RandomAerospace/COMMS-BOARD/Board screenshots/COMMS_BOARD_top.png

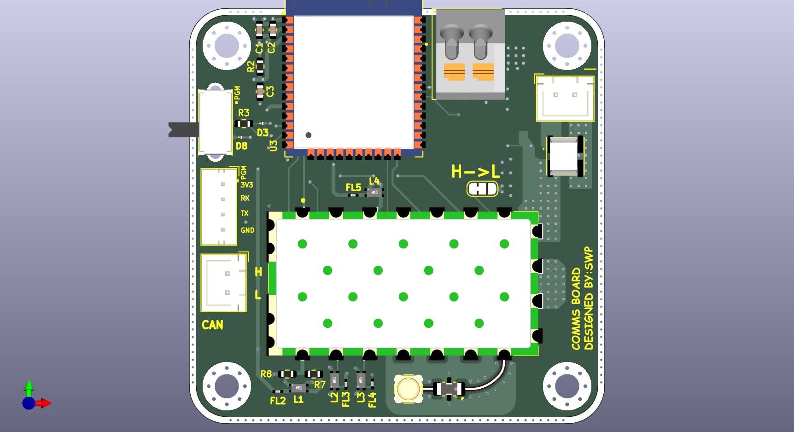
Board screenshots/COMMS_BOARD_top.png
