RandomAerospace/COMMS-BOARD/Board screenshots/COMMS_BOARD_REV1_BOTTOM.png

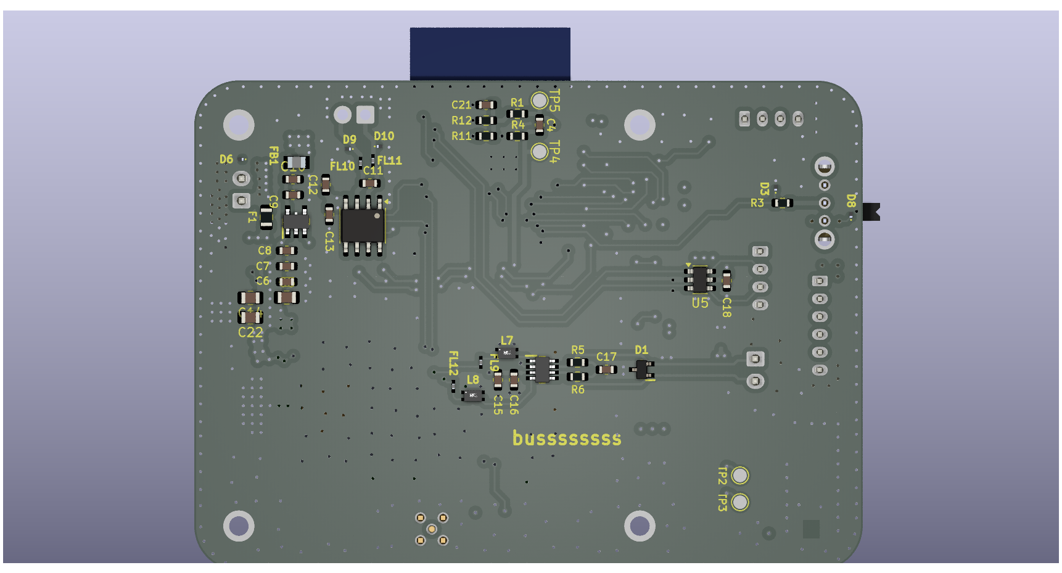
Board screenshots/COMMS_BOARD_REV1_BOTTOM.png
