RandomAerospace/COMMS-BOARD/README.md

Comms board with APRS GNSS
V1 has been flight tested, V2 has fixed existing issues under issues tab
Accompanying firmware: https://github.com/RandomAerospace/BEAR13_FIRMWARE
Summary of the project, presented at SARTS: https://www.sarts.org.sg/presentations-quarterly-meeting-may-2026/
