RandomAerospace/COMMS-BOARD/Board screenshots/7b1loe.png

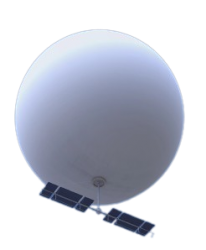
Board screenshots/7b1loe.png
