RandomAerospace/COMMS-BOARD/Board screenshots/COMMS_BOARD_bott.png

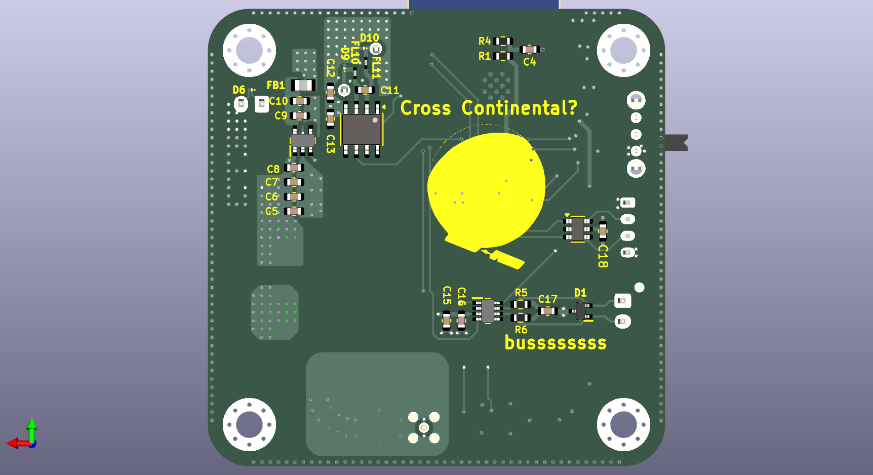
Board screenshots/COMMS_BOARD_bott.png
