RandomAerospace/COMMS-BOARD/Board screenshots/COMMS_BOARD_isometric.png

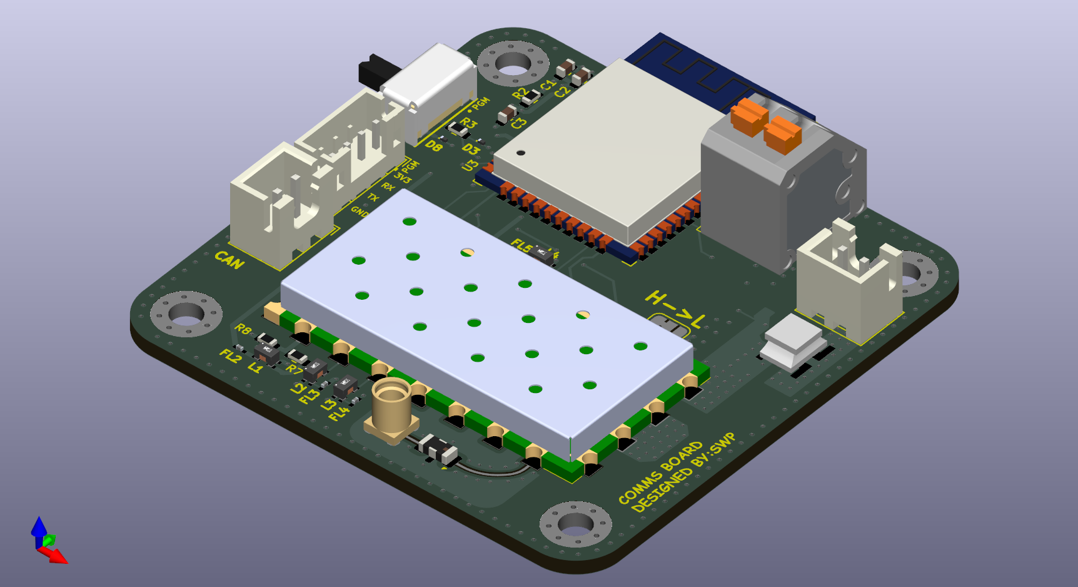
Board screenshots/COMMS_BOARD_isometric.png
