RandomAerospace/COMMS-BOARD/Board screenshots/COMMS_BOARD_isometric_bot.png

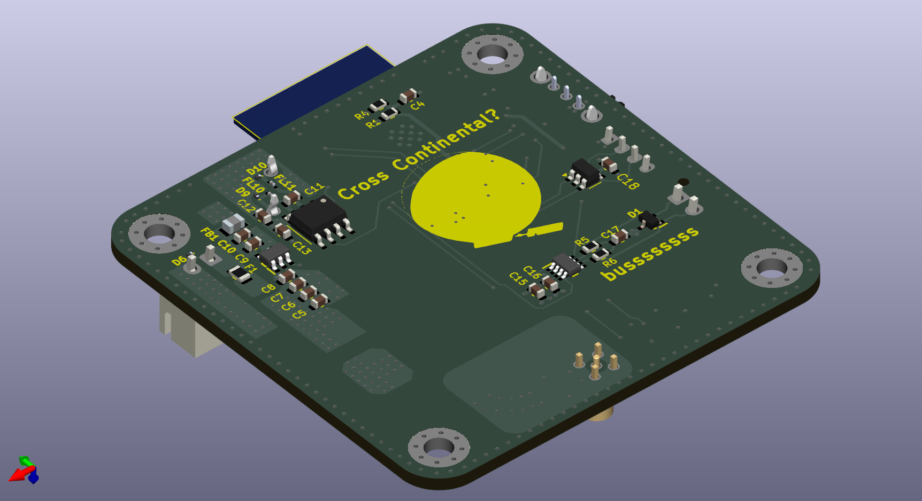
Board screenshots/COMMS_BOARD_isometric_bot.png
