RandomAerospace/COMMS-BOARD/Board screenshots/COMMS_BOARD_REV1.png

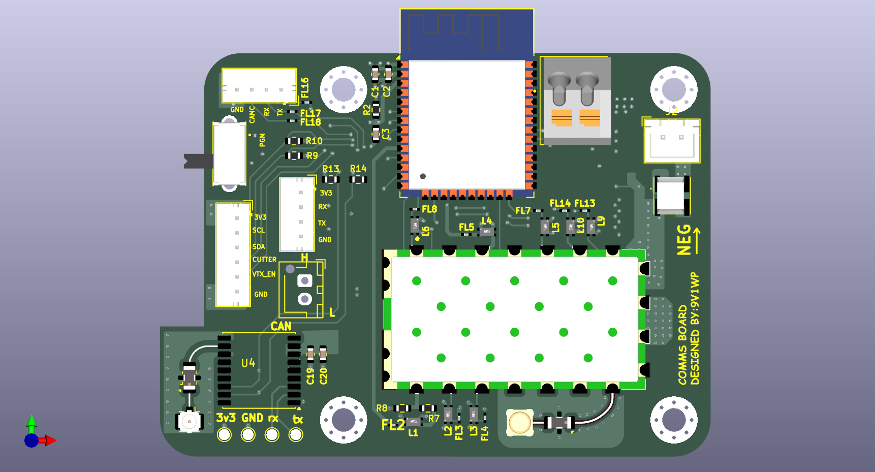
Board screenshots/COMMS_BOARD_REV1.png
