RandomAerospace/COMMS-BOARD/Board screenshots/COMMS_BOARD_REV1_AUDIO.png

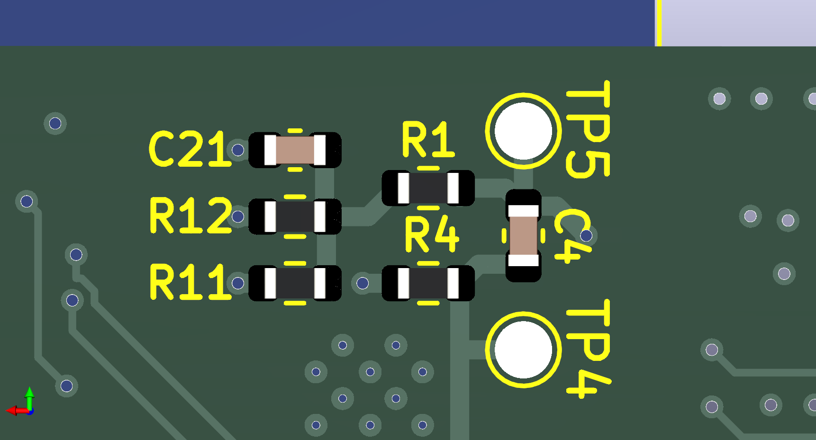
Board screenshots/COMMS_BOARD_REV1_AUDIO.png
