RandomAerospace/COMMS-BOARD/Board screenshots/COMMS_BOARD_REV1_GNSS_RAD.png

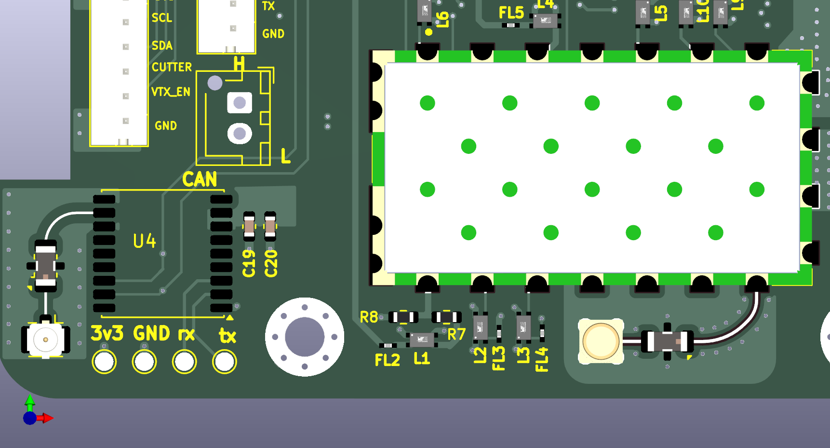
Board screenshots/COMMS_BOARD_REV1_GNSS_RAD.png
