RandomAerospace/COMMS-BOARD/Board screenshots/COMMS_BOARD_REV1_ISO.png

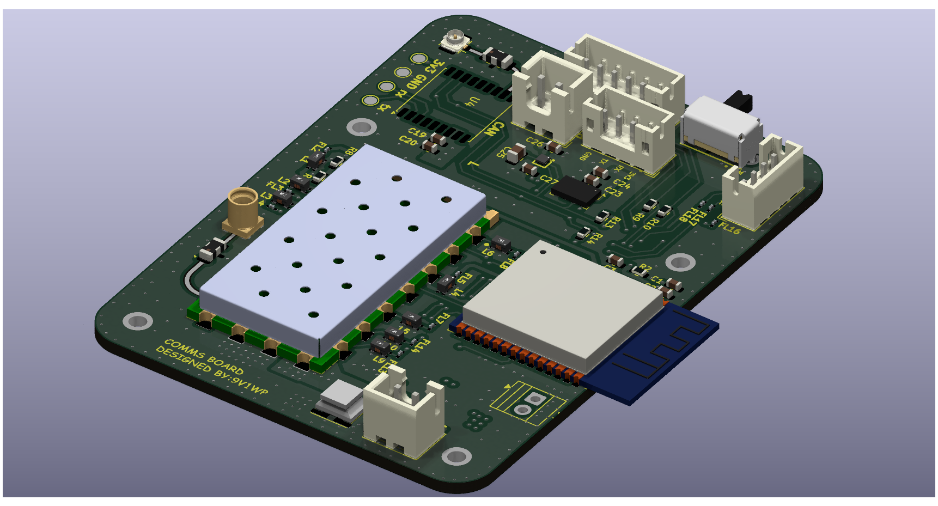
Board screenshots/COMMS_BOARD_REV1_ISO.png
