RandomAerospace/COMMS-BOARD/Board screenshots/COMMS_BOARD_REV1_TOP.png

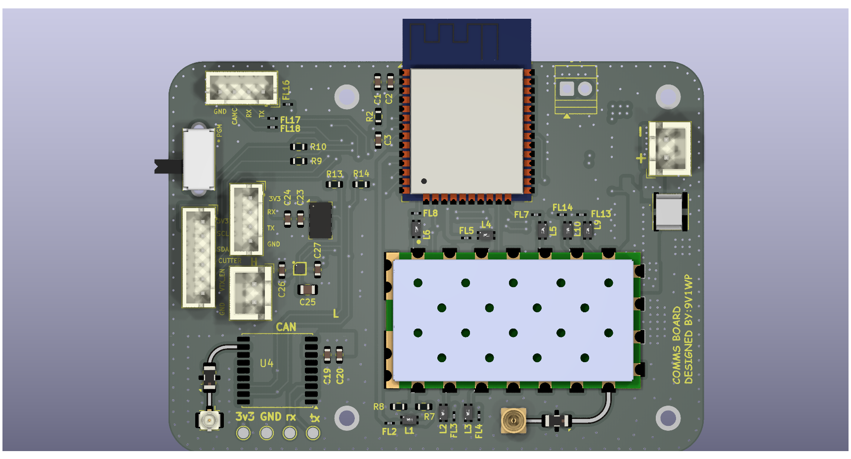
Board screenshots/COMMS_BOARD_REV1_TOP.png
