RandomAerospace/COMMS-BOARD/Board screenshots/COMMS_BOARD_REV2_TOP.png

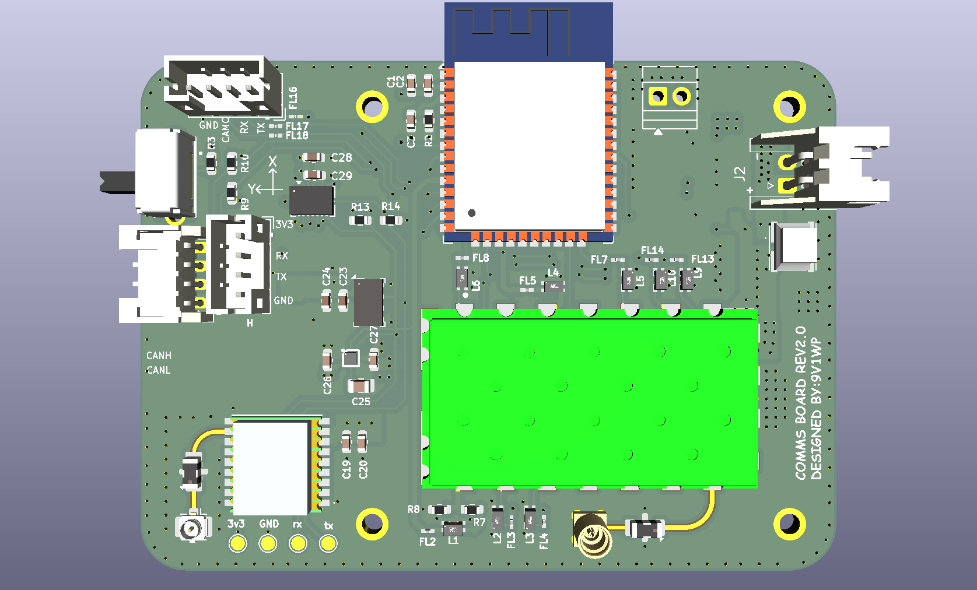
Board screenshots/COMMS_BOARD_REV2_TOP.png
