RandomAerospace/COMMS-BOARD/Board screenshots/EditorialAnyiChong.png

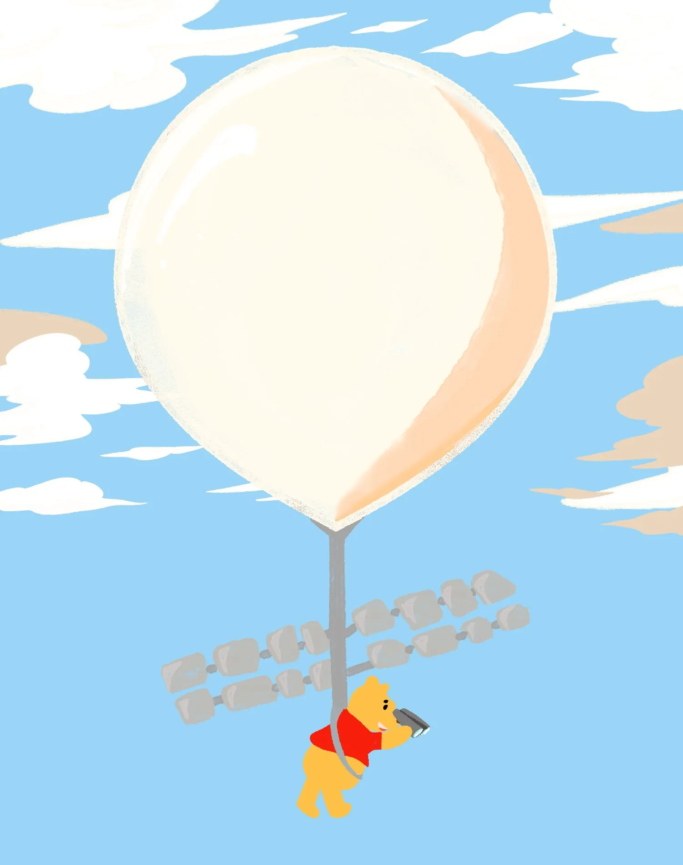
Board screenshots/EditorialAnyiChong.png
