RandomAerospace/COMMS-BOARD/Common Mode choke pic.PNG

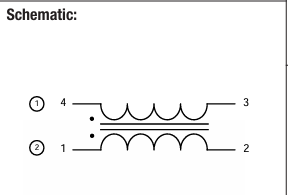
Common Mode choke pic.PNG
