RandomAerospace/COMMS-BOARD/dbv_layout.PNG

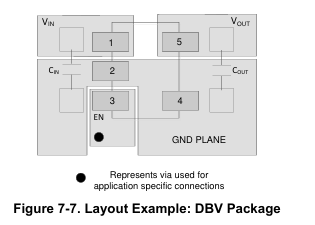
dbv_layout.PNG
