RandomAerospace/COMMS-BOARD/jlc_controlled_impedence.PNG

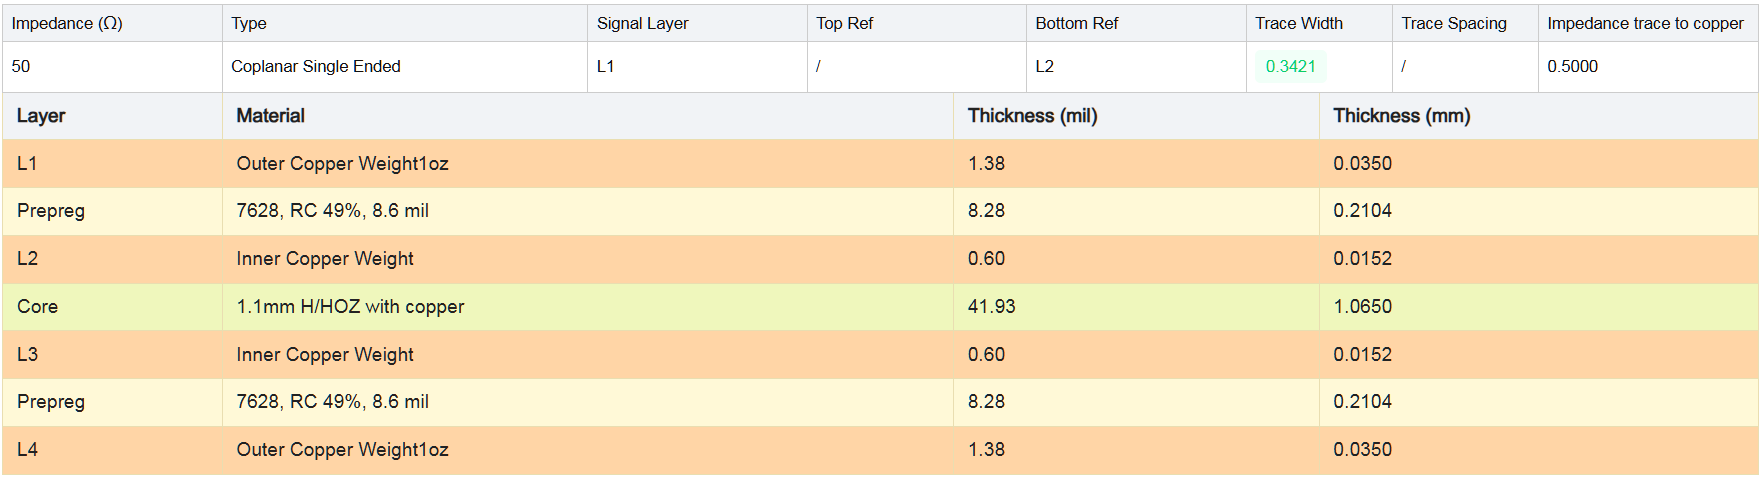
jlc_controlled_impedence.PNG
