RandomAerospace/COMMS-BOARD/lcn-160tw.PNG

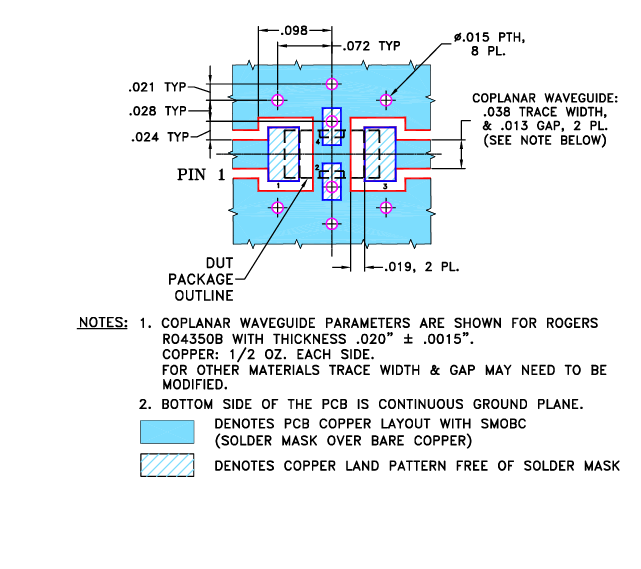
lcn-160tw.PNG
