RandomAerospace/COMMS-BOARD/POWER_Common_mode_choke.PNG

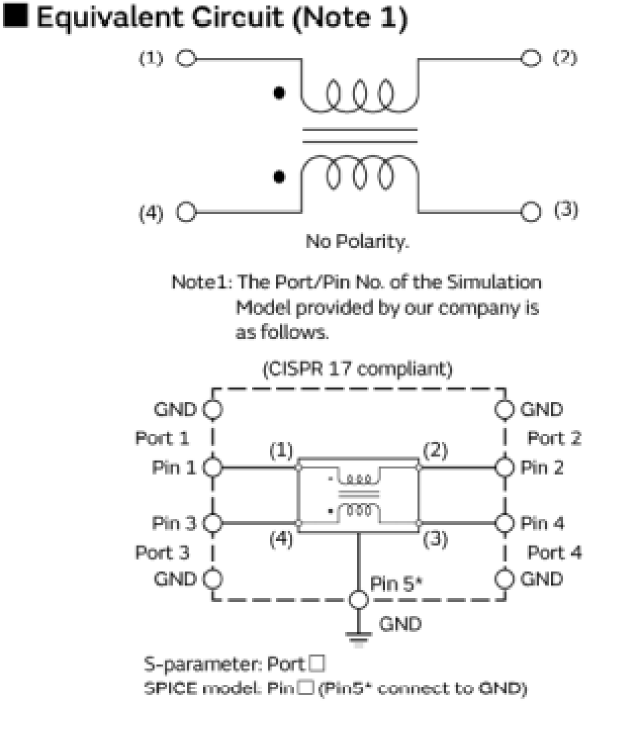
POWER_Common_mode_choke.PNG
