RandomAerospace/COMMS-BOARD/kicad-VHF-UHF-modules-main/DRA818V.step

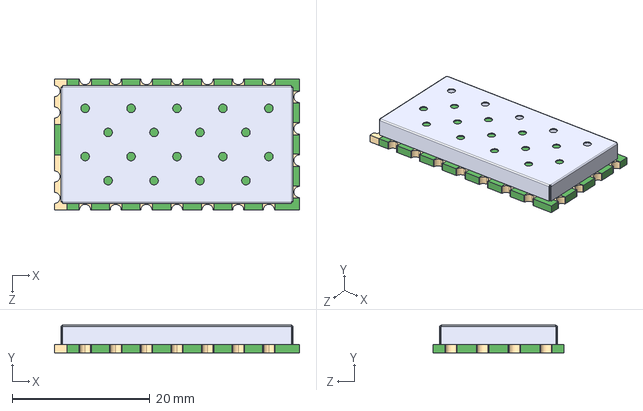
[picture p19: CAD file, 2026-03-12]
kicad-VHF-UHF-modules-main/DRA818V.step
35.6 x 4.00 x 19.0 mm
