RandomAerospace/COMMS-BOARD/LTspice files/sa818s(1).dxf

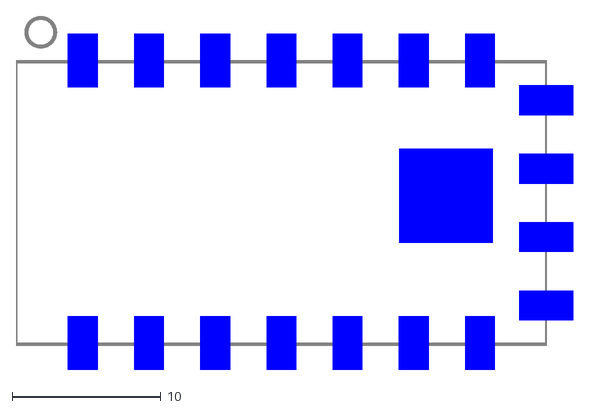
[picture p20: CAD file, 2026-03-12]
LTspice files/sa818s(1).dxf
TP1
