RandomAerospace/COMMS-BOARD/(list of files, drawings)

Other design files:
LTspice files/sa818s.pcb
