RandomAerospace/COMMS-BOARD/COMMS_BOARD.kicad_pcb

## KiCad design COMMS_BOARD.kicad_pcb (2026-08-10)

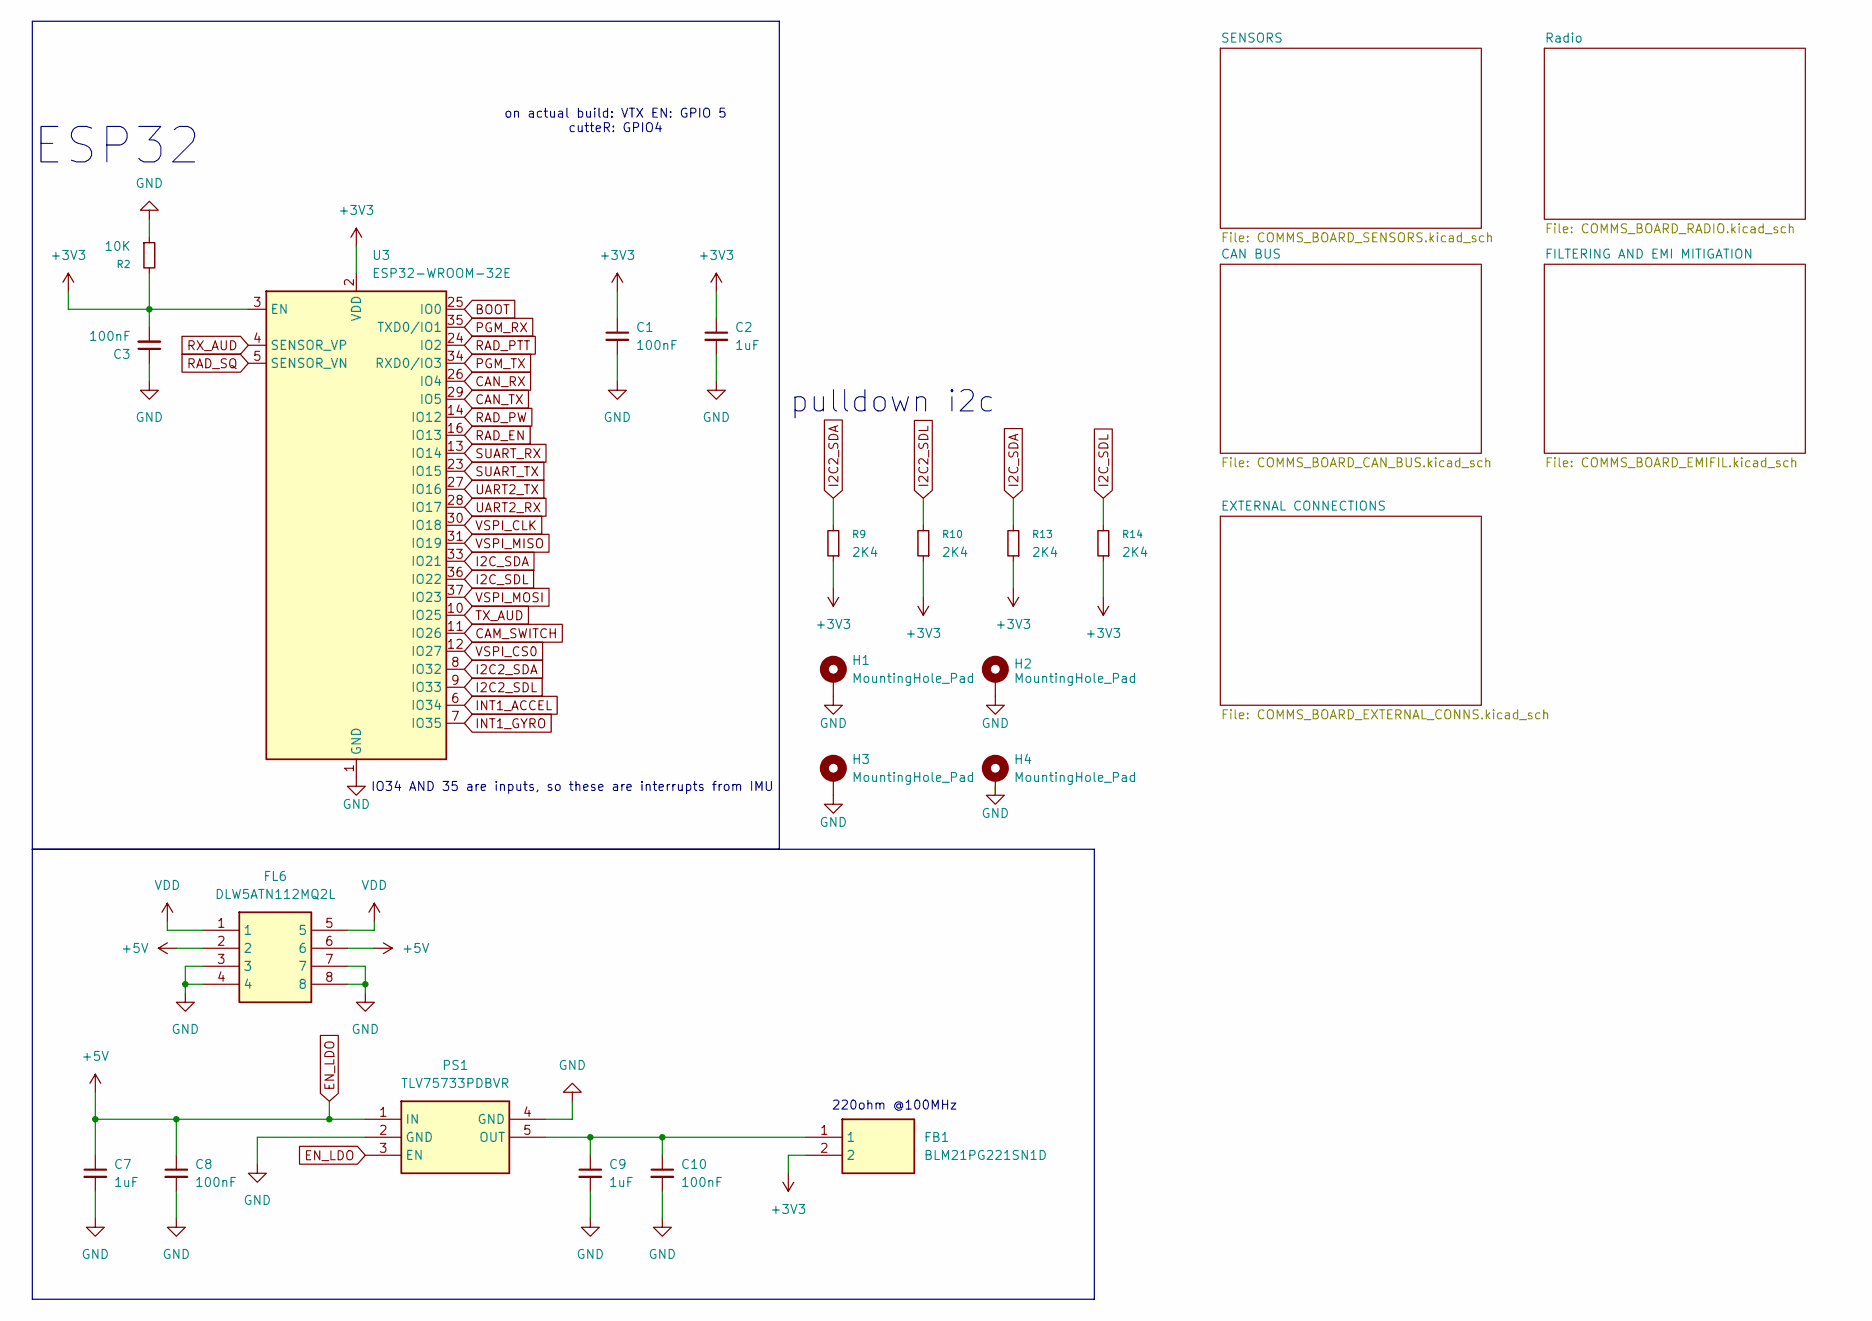
[picture p39: schematic COMMS_BOARD.kicad_sch]

Parts:
C1, C3, C8, C10: 100nF; C_0603_1608Metric
C2, C7, C9: 1uF; C_0603_1608Metric
FB1: BLM21PG221SN1D; BEADC2012X105N; Mouser Part Number 81-BLM21P221SG
FL6: DLW5ATN112MQ2L; DLW5BSN302SQ2L; Mouser Part Number 81-DLW5ATN112MQ2L
H1, H2, H3, H4: MountingHole_Pad; MountingHole_2.2mm_M2_ISO7380_Pad
PS1: TLV75733PDBVR; SOT95P280X145-5N; Mouser Part Number 595-TLV75733PDBVR
R2: 10K; R_0603_1608Metric
R9, R10, R13, R14: 2K4; R_0603_1608Metric
U3: ESP32-WROOM-32E; ESP32-WROOM-32D

Connections:
+3V3: C1.1, C2.1, C3.2, FB1.2, R2.2, R9.1, R10.1, R13.1, R14.1, U3.2 (VDD), U3.3 (EN); also elsewhere on the board
BOOT: U3.25 (IO0); also elsewhere on the board
CAM_SWITCH: U3.11 (IO26); also elsewhere on the board
CAN_RX: U3.26 (IO4); also elsewhere on the board
CAN_TX: U3.29 (IO5); also elsewhere on the board
EN_LDO: C7.1, C8.1, FL6.2, FL6.6, PS1.1 (IN), PS1.3 (EN); also elsewhere on the board
GND: C1.2, C2.2, C3.1, C7.2, C8.2, C9.2, C10.2, FL6.3, FL6.4, FL6.7, FL6.8, H1.1 (1_1), H2.1 (1_1), H3.1 (1_1), H4.1 (1_1), PS1.2 (GND), PS1.4 (GND), R2.1, U3.1 (GND), U3.15 (GND), U3.38 (GND), U3.39 (GND); also elsewhere on the board
I2C2_SDA: R9.2, U3.8 (IO32); also elsewhere on the board
I2C2_SDL: R10.2, U3.9 (IO33); also elsewhere on the board
I2C_SDA: R13.2, U3.33 (IO21); also elsewhere on the board
I2C_SDL: R14.2, U3.36 (IO22); also elsewhere on the board
INT1_ACCEL: U3.6 (IO34); also elsewhere on the board
INT1_GYRO: U3.7 (IO35); also elsewhere on the board
unnamed: FL6.1, FL6.5
unnamed: C9.1, C10.1, FB1.1, PS1.5 (OUT)
PGM_RX: U3.35 (TXD0/IO1); also elsewhere on the board
PGM_TX: U3.34 (RXD0/IO3); also elsewhere on the board
RAD_EN: U3.16 (IO13); also elsewhere on the board
RAD_PTT: U3.24 (IO2); also elsewhere on the board
RAD_PW: U3.14 (IO12); also elsewhere on the board
RAD_SQ: U3.5 (SENSOR_VN); also elsewhere on the board
RX_AUD: U3.4 (SENSOR_VP); also elsewhere on the board
SUART_RX: U3.13 (IO14); also elsewhere on the board
SUART_TX: U3.23 (IO15); also elsewhere on the board
TX_AUD: U3.10 (IO25); also elsewhere on the board
UART2_RX: U3.28 (IO17); also elsewhere on the board
UART2_TX: U3.27 (IO16); also elsewhere on the board
VSPI_CLK: U3.30 (IO18); also elsewhere on the board
VSPI_CS0: U3.12 (IO27); also elsewhere on the board
VSPI_MISO: U3.31 (IO19); also elsewhere on the board
VSPI_MOSI: U3.37 (IO23)

Notes on the sheet:
pulldown i2c
ESP32
IO34 AND 35 are inputs, so these are interrupts from IMU
220ohm @100MHz
on actual build: VTX EN: GPIO 5 cutteR: GPIO4

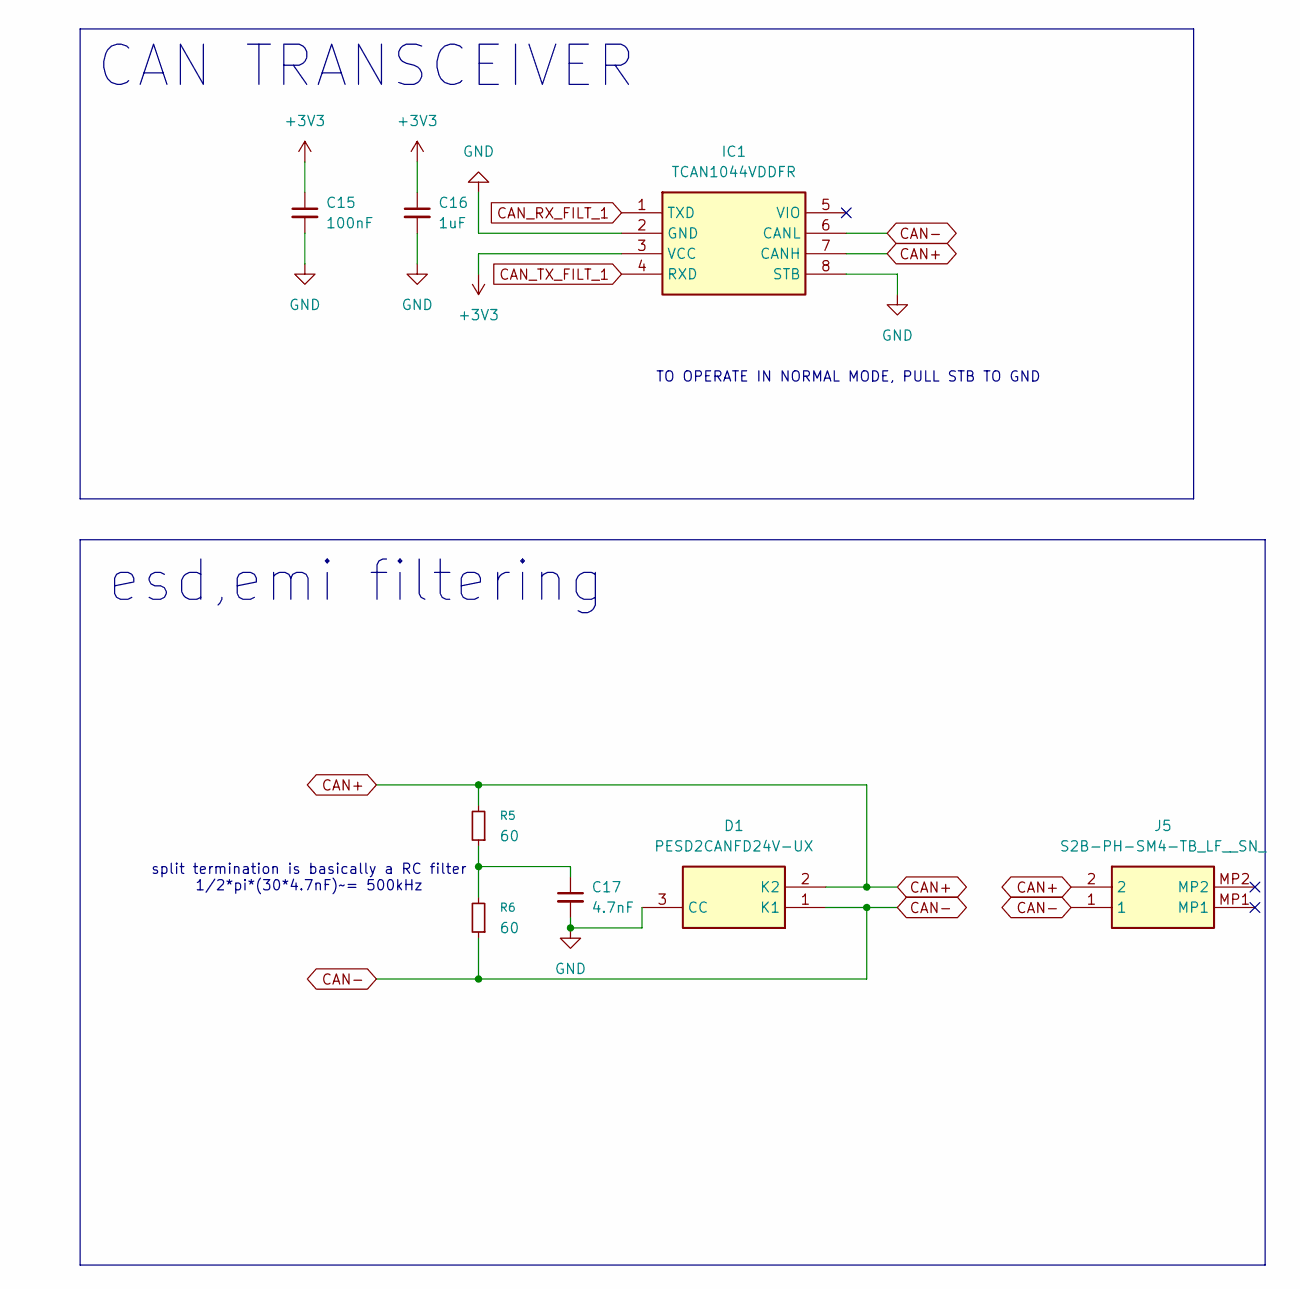
[picture p40: schematic COMMS_BOARD_CAN_BUS.kicad_sch]

Parts:
C15: 100nF; C_0603_1608Metric
C16: 1uF; C_0603_1608Metric
C17: 4.7nF; C_0603_1608Metric
D1: PESD2CANFD24V-UX; SOT65P210X110-3N; Mouser Part Number 771-PESD2CANFD24V-UX
IC1: TCAN1044VDDFR; SOT65P280X110-8N; Mouser Part Number 595-TCAN1044VDDFR
J5: S2B-PH-SM4-TB_LF__SN_; S2BPHSM4TBLFSN; Mouser Part Number N/A
R5, R6: 60; R_0603_1608Metric

Connections:
+3V3: C15.1, C16.1, IC1.3 (VCC); also elsewhere on the board
CAN+: D1.2 (K2), IC1.7 (CANH), J5.2, R5.2
CAN-: D1.1 (K1), IC1.6 (CANL), J5.1, R6.1
CAN_RX_FILT_1: IC1.1 (TXD); also elsewhere on the board
CAN_TX_FILT_1: IC1.4 (RXD); also elsewhere on the board
GND: C15.2, C16.2, C17.2, D1.3 (CC), IC1.2 (GND), IC1.8 (STB); also elsewhere on the board
unnamed: C17.1, R5.1, R6.2

Notes on the sheet:
split termination is basically a RC filter 1/2*pi*(30*4.7nF)~= 500kHz
esd,emi filtering
TO OPERATE IN NORMAL MODE, PULL STB TO GND
CAN TRANSCEIVER

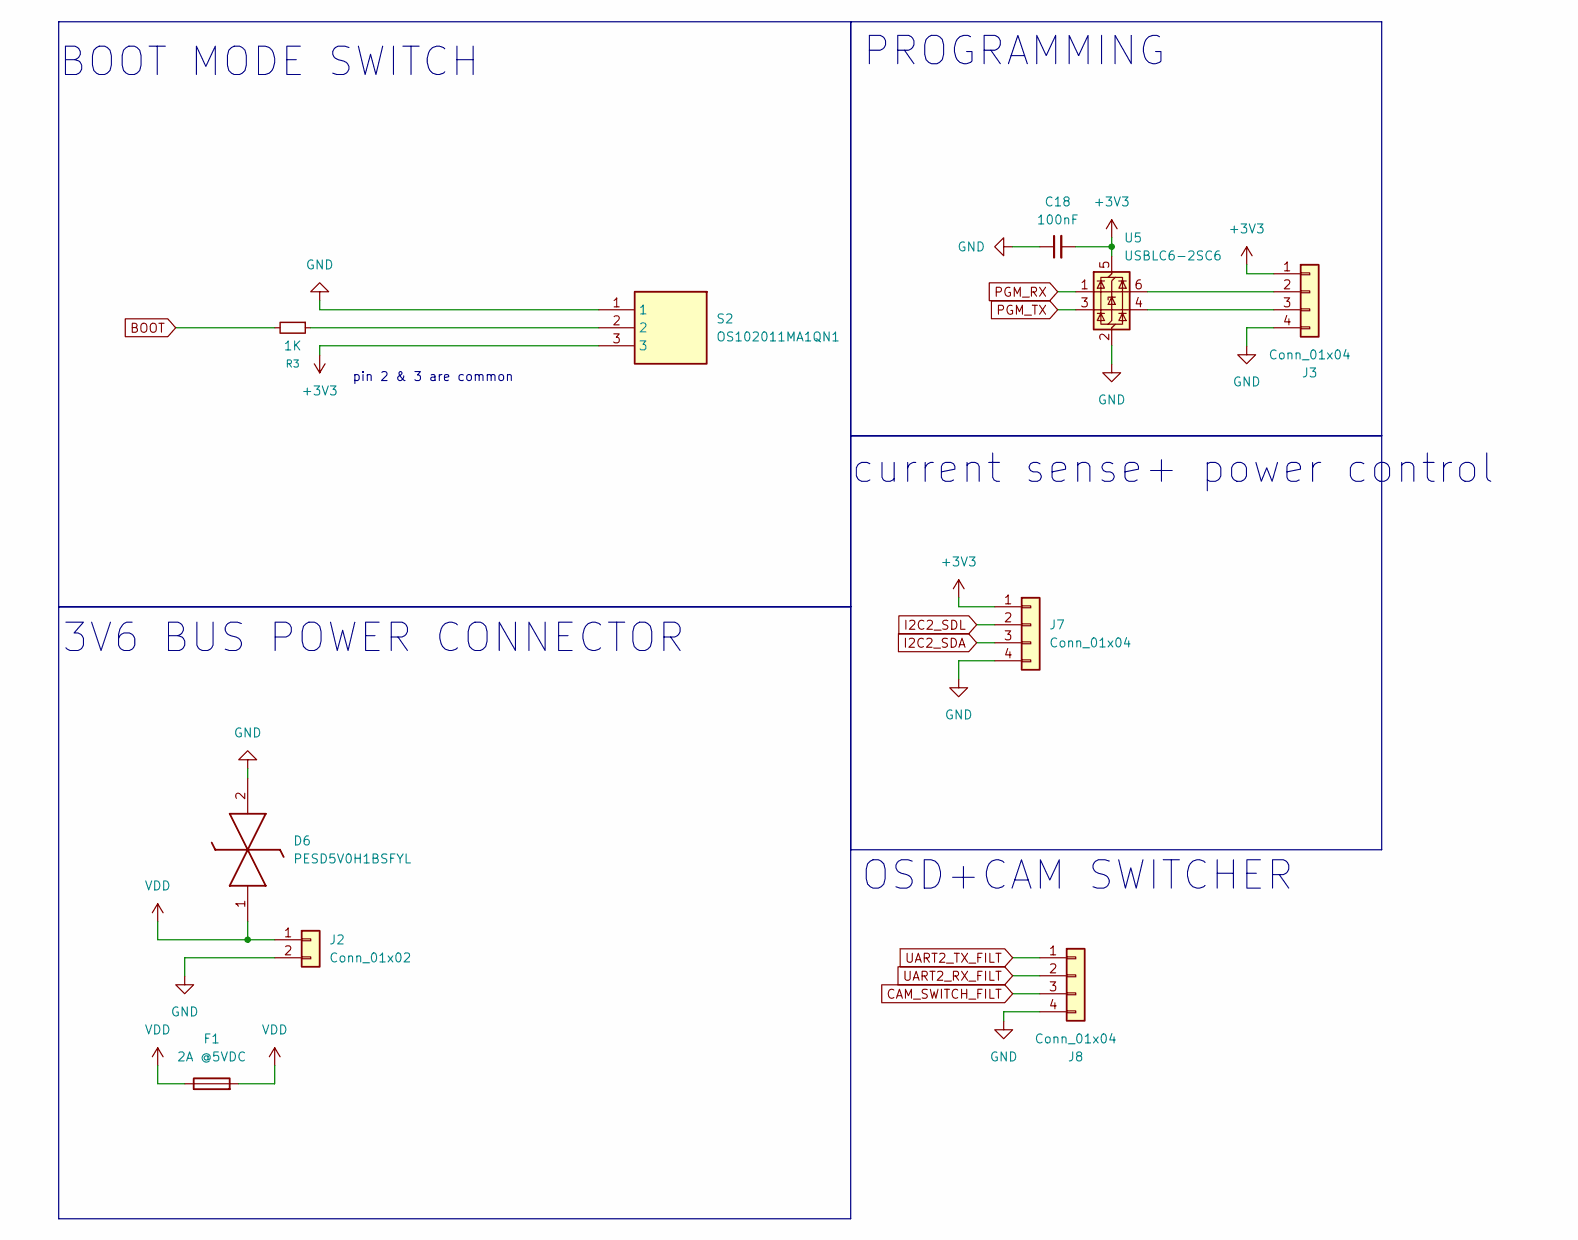
[picture p41: schematic COMMS_BOARD_EXTERNAL_CONNS.kicad_sch]

Parts:
C18: 100nF; C_0603_1608Metric
D6: PESD5V0H1BSFYL; PMEG3005AESFYL; Mouser Part Number 771-PESD5V0H1BSFYL
F1: 2A @5VDC; Fuse_0805_2012Metric
J2: Conn_01x02; JST_XH_S2B-XH-A-1_1x02_P2.50mm_Horizontal
J3, J8: Conn_01x04; JST_PH_B4B-PH-K_1x04_P2.00mm_Vertical
J7: Conn_01x04; JST_PH_S4B-PH-K_1x04_P2.00mm_Horizontal
R3: 1K; R_0603_1608Metric
S2: OS102011MA1QN1; Mouser Part Number 611-OS102011MA1QN1
U5: USBLC6-2SC6; SOT-23-6

Connections:
+3V3: C18.2, J3.1, J7.1, S2.3, U5.5 (VBUS); also elsewhere on the board
BOOT: R3.2; also elsewhere on the board
CAM_SWITCH_FILT: J8.3; also elsewhere on the board
GND: C18.1, D6.2 (K2), J2.2, J3.4, J7.4, J8.4, S2.1, U5.2 (GND); also elsewhere on the board
I2C2_SDA: J7.3; also elsewhere on the board
I2C2_SDL: J7.2; also elsewhere on the board
unnamed: J3.2, U5.6 (I/O1)
unnamed: J3.3, U5.4 (I/O2)
unnamed: R3.1, S2.2
PGM_RX: U5.1 (I/O1); also elsewhere on the board
PGM_TX: U5.3 (I/O2); also elsewhere on the board
UART2_RX_FILT: J8.2; also elsewhere on the board
UART2_TX_FILT: J8.1; also elsewhere on the board
VDD: D6.1 (K1), F1.1, F1.2, J2.1; also elsewhere on the board

Notes on the sheet:
PROGRAMMING
current sense+ power control
pin 2 & 3 are common
OSD+CAM SWITCHER
3V6 BUS POWER CONNECTOR
BOOT MODE SWITCH

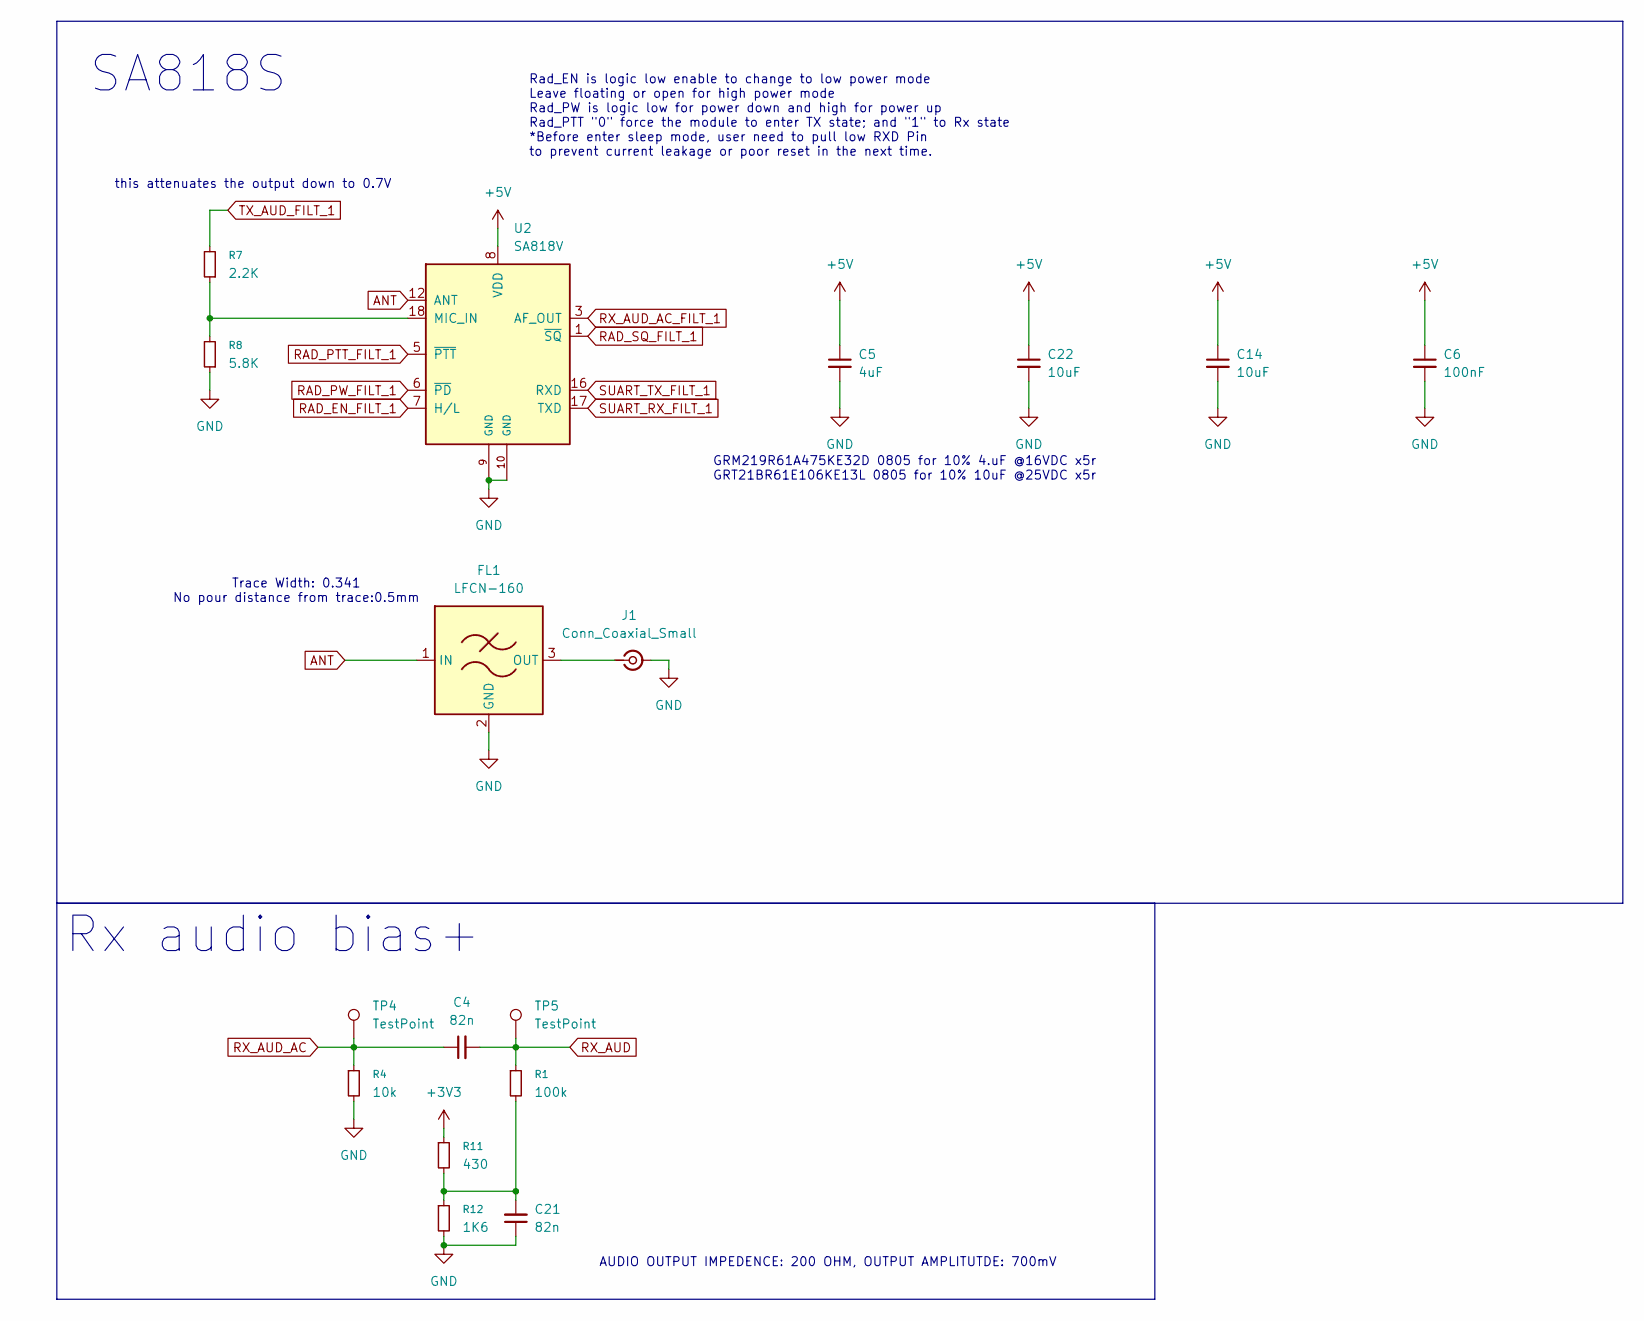
[picture p42: schematic COMMS_BOARD_RADIO.kicad_sch]

Parts:
C4, C21: 82n; C_0603_1608Metric
C5: 4uF; C_0805_2012Metric
C6: 100nF; C_0603_1608Metric
C14, C22: 10uF; C_0805_2012Metric
FL1: LFCN-160; Filter_Mini-Circuits_FV1206
J1: Conn_Coaxial_Small; MMCX_Molex_73415-1471_Vertical
R1: 100k; R_0603_1608Metric
R4: 10k; R_0603_1608Metric
R7: 2.2K; R_0603_1608Metric
R8: 5.8K; R_0603_1608Metric
R11: 430; R_0603_1608Metric
R12: 1K6; R_0603_1608Metric
TP4, TP5: TestPoint; TestPoint_Pad_D1.5mm
U2: SA818V; VHF_UHF_Module_generic

Connections:
+3V3: R11.1; also elsewhere on the board
ANT: FL1.1 (IN), U2.12 (ANT)
EN_LDO: C5.1, C6.1, C14.1, C22.1, U2.8 (VDD); also elsewhere on the board
GND: C5.2, C6.2, C14.2, C21.1, C22.2, FL1.2 (GND), FL1.4 (GND), J1.2 (Ext), R4.2, R8.1, R12.2, U2.9 (GND), U2.10 (GND); also elsewhere on the board
unnamed: C21.2, R1.2, R11.2, R12.1
unnamed: FL1.3 (OUT), J1.1 (In)
unnamed: R7.1, R8.2, U2.18 (MIC_IN)
RAD_EN_FILT_1: U2.7 (H/L); also elsewhere on the board
RAD_PTT_FILT_1: U2.5 (~PTT); also elsewhere on the board
RAD_PW_FILT_1: U2.6 (~PD); also elsewhere on the board
RAD_SQ_FILT_1: U2.1 (~SQ); also elsewhere on the board
RX_AUD: C4.2, R1.1, TP5.1 (1_1); also elsewhere on the board
RX_AUD_AC: C4.1, R4.1, TP4.1 (1_1); also elsewhere on the board
RX_AUD_AC_FILT_1: U2.3 (AF_OUT); also elsewhere on the board
SUART_RX_FILT_1: U2.17 (TXD); also elsewhere on the board
SUART_TX_FILT_1: U2.16 (RXD); also elsewhere on the board
TX_AUD_FILT_1: R7.2; also elsewhere on the board

Notes on the sheet:
SA818S
Trace Width: 0.341 No pour distance from trace:0.5mm
Rad_EN is logic low enable to change to low power mode Leave floating or open for high power mode Rad_PW is logic low for power down and high for power up Rad_PTT "0" force the module to enter TX state; and "1" to Rx state *Before enter sleep mode, user need to pull low RXD Pin to prevent current l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
this attenuates the output down to 0.7V
GRM219R61A475KE32D 0805 for 10% 4.uF @16VDC x5r GRT21BR61E106KE13L 0805 for 10% 10uF @25VDC x5r
Rx audio bias+
AUDIO OUTPUT IMPEDENCE: 200 OHM, OUTPUT AMPLITUTDE: 700mV

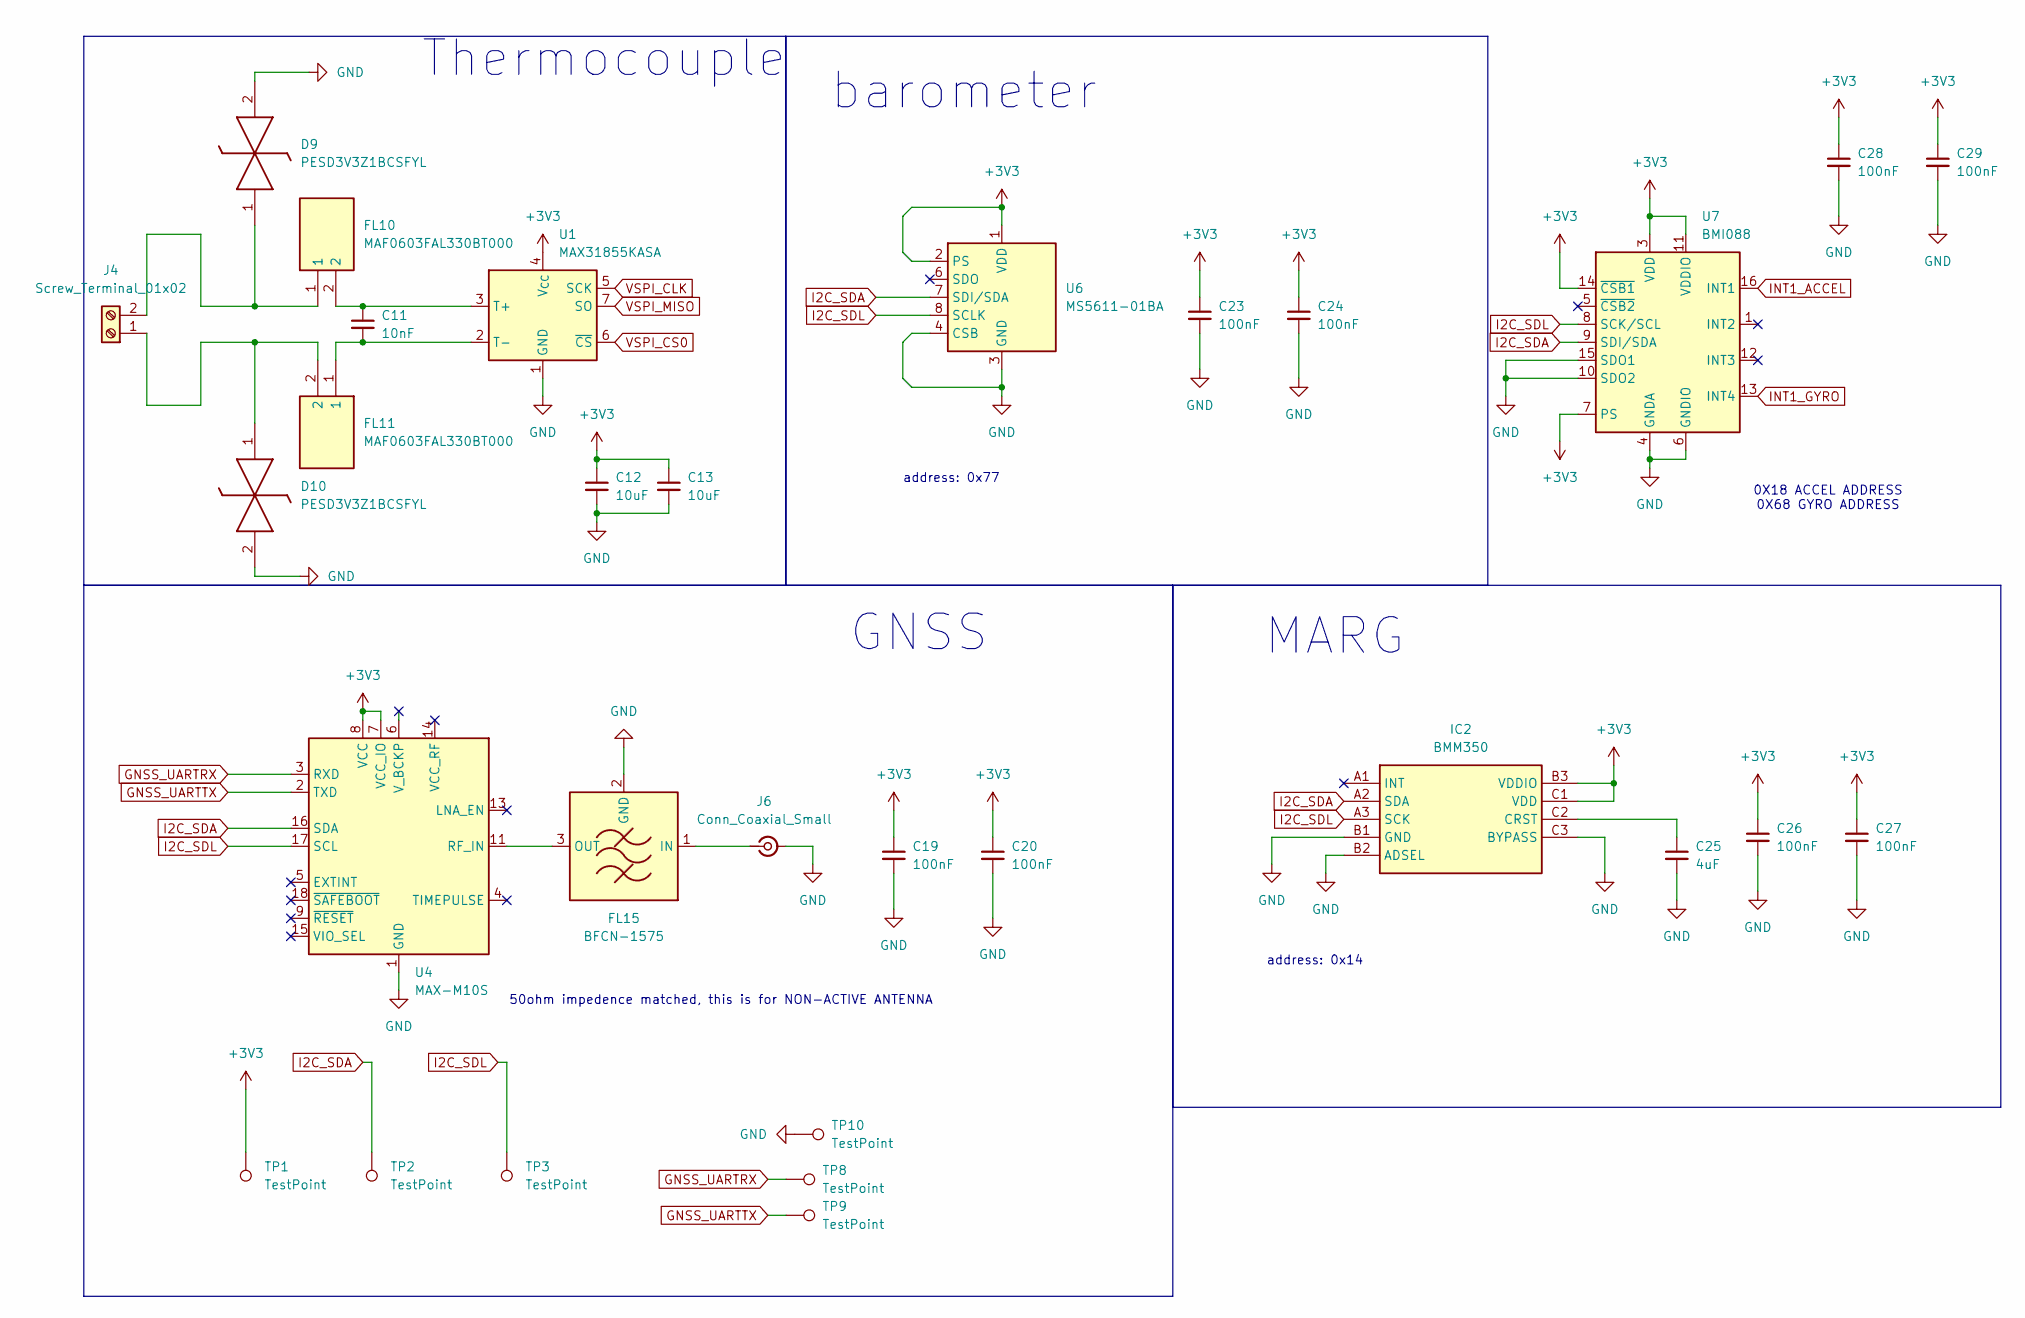
[picture p43: schematic COMMS_BOARD_SENSORS.kicad_sch]

Parts:
C11: 10nF; C_0603_1608Metric
C12, C13: 10uF; C_0603_1608Metric
C19, C20, C23, C24, C26, C27, C28, C29: 100nF; C_0603_1608Metric
C25: 4uF; C_0805_2012Metric
D9, D10: PESD3V3Z1BCSFYL; PMEG3005AESFYL; Mouser Part Number 771-PESD3V3Z1BCSFYL
FL10, FL11: MAF0603FAL330BT000; BEADC0603X33N; Mouser Part Number 810-MAF0603FAL330BT0
FL15: BFCN-1575; Filter_Mini-Circuits_FV1206
IC2: BMM350; BGA9C40P3X3_128X128X54; Mouser Part Number 262-BMM350
J4: Screw_Terminal_01x02; TerminalBlock_Xinya_XY308-2.54-2P_1x02_P2.54mm_Horizontal
J6: Conn_Coaxial_Small; U.FL_Hirose_U.FL-R-SMT-1_Vertical
TP1, TP2, TP3, TP8, TP9, TP10: TestPoint; TestPoint_Pad_D1.5mm
U1: MAX31855KASA; SOIC-8_3.9x4.9mm_P1.27mm
U4: MAX-M10S; ublox_MAX
U6: MS5611-01BA; LGA-8_3x5mm_P1.25mm
U7: BMI088; Bosch_LGA-16_4.5x3mm_P0.5mm_LayoutBorder7x1y_ClockwisePinNu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

Connections:
+3V3: C12.1, C13.1, C19.1, C20.1, C23.1, C24.1, C26.1, C27.1, C28.1, C29.1, IC2.B3 (VDDIO), IC2.C1 (VDD), TP1.1 (1_1), U1.4 (V_{CC}), U4.7 (VCC_IO), U4.8 (VCC), U6.1 (VDD), U6.2 (PS), U7.3 (VDD), U7.7 (PS), U7.11 (VDDIO), U7.14 (~CSB1); also elsewhere on the board
GND: C12.2, C13.2, C19.2, C20.2, C23.2, C24.2, C25.2, C26.2, C27.2, C28.2, C29.2, D9.2 (K2), D10.2 (K2), FL15.2 (GND), FL15.4 (GND), IC2.B1 (GND), IC2.B2 (ADSEL), IC2.C3 (BYPASS), J6.2 (Ext), TP10.1 (1_1), U1.1 (GND), U4.1 (GND), U4.10 (GND), U4.12 (GND), U6.3 (GND), U6.4 (CSB), U6.5 (CSB), U7.2 (GNDA), U7.4 (GNDA), U7.6 (GNDIO), U7.10 (SDO2), U7.15 (SDO1); also elsewhere on the board
GNSS_UARTRX: TP8.1 (1_1), U4.3 (RXD); also elsewhere on the board
GNSS_UARTTX: TP9.1 (1_1), U4.2 (TXD); also elsewhere on the board
I2C_SDA: IC2.A2 (SDA), TP2.1 (1_1), U4.16 (SDA), U6.7 (SDI/SDA), U7.9 (SDI/SDA); also elsewhere on the board
I2C_SDL: IC2.A3 (SCK), TP3.1 (1_1), U4.17 (SCL), U6.8 (SCLK), U7.8 (SCK/SCL); also elsewhere on the board
INT1_ACCEL: U7.16 (INT1); also elsewhere on the board
INT1_GYRO: U7.13 (INT4); also elsewhere on the board
unnamed: D9.1 (K1), FL10.1, J4.2
unnamed: D10.1 (K1), FL11.2, J4.1
unnamed: FL15.1 (IN), J6.1 (In)
unnamed 30: FL15.3 (OUT), U4.11 (RF_IN); also elsewhere on the board
unnamed: C25.1, IC2.C2 (CRST)
unnamed: C11.1, FL10.2, U1.3 (T+)
unnamed: C11.2, FL11.1, U1.2 (T-)
VSPI_CLK: U1.5 (SCK); also elsewhere on the board
VSPI_CS0: U1.6 (~CS); also elsewhere on the board
VSPI_MISO: U1.7 (SO); also elsewhere on the board

Notes on the sheet:
0X18 ACCEL ADDRESS 0X68 GYRO ADDRESS
address: 0x14
barometer
address: 0x77
GNSS
MARG
Thermocouple
50ohm impedence matched, this is for NON-ACTIVE ANTENNA

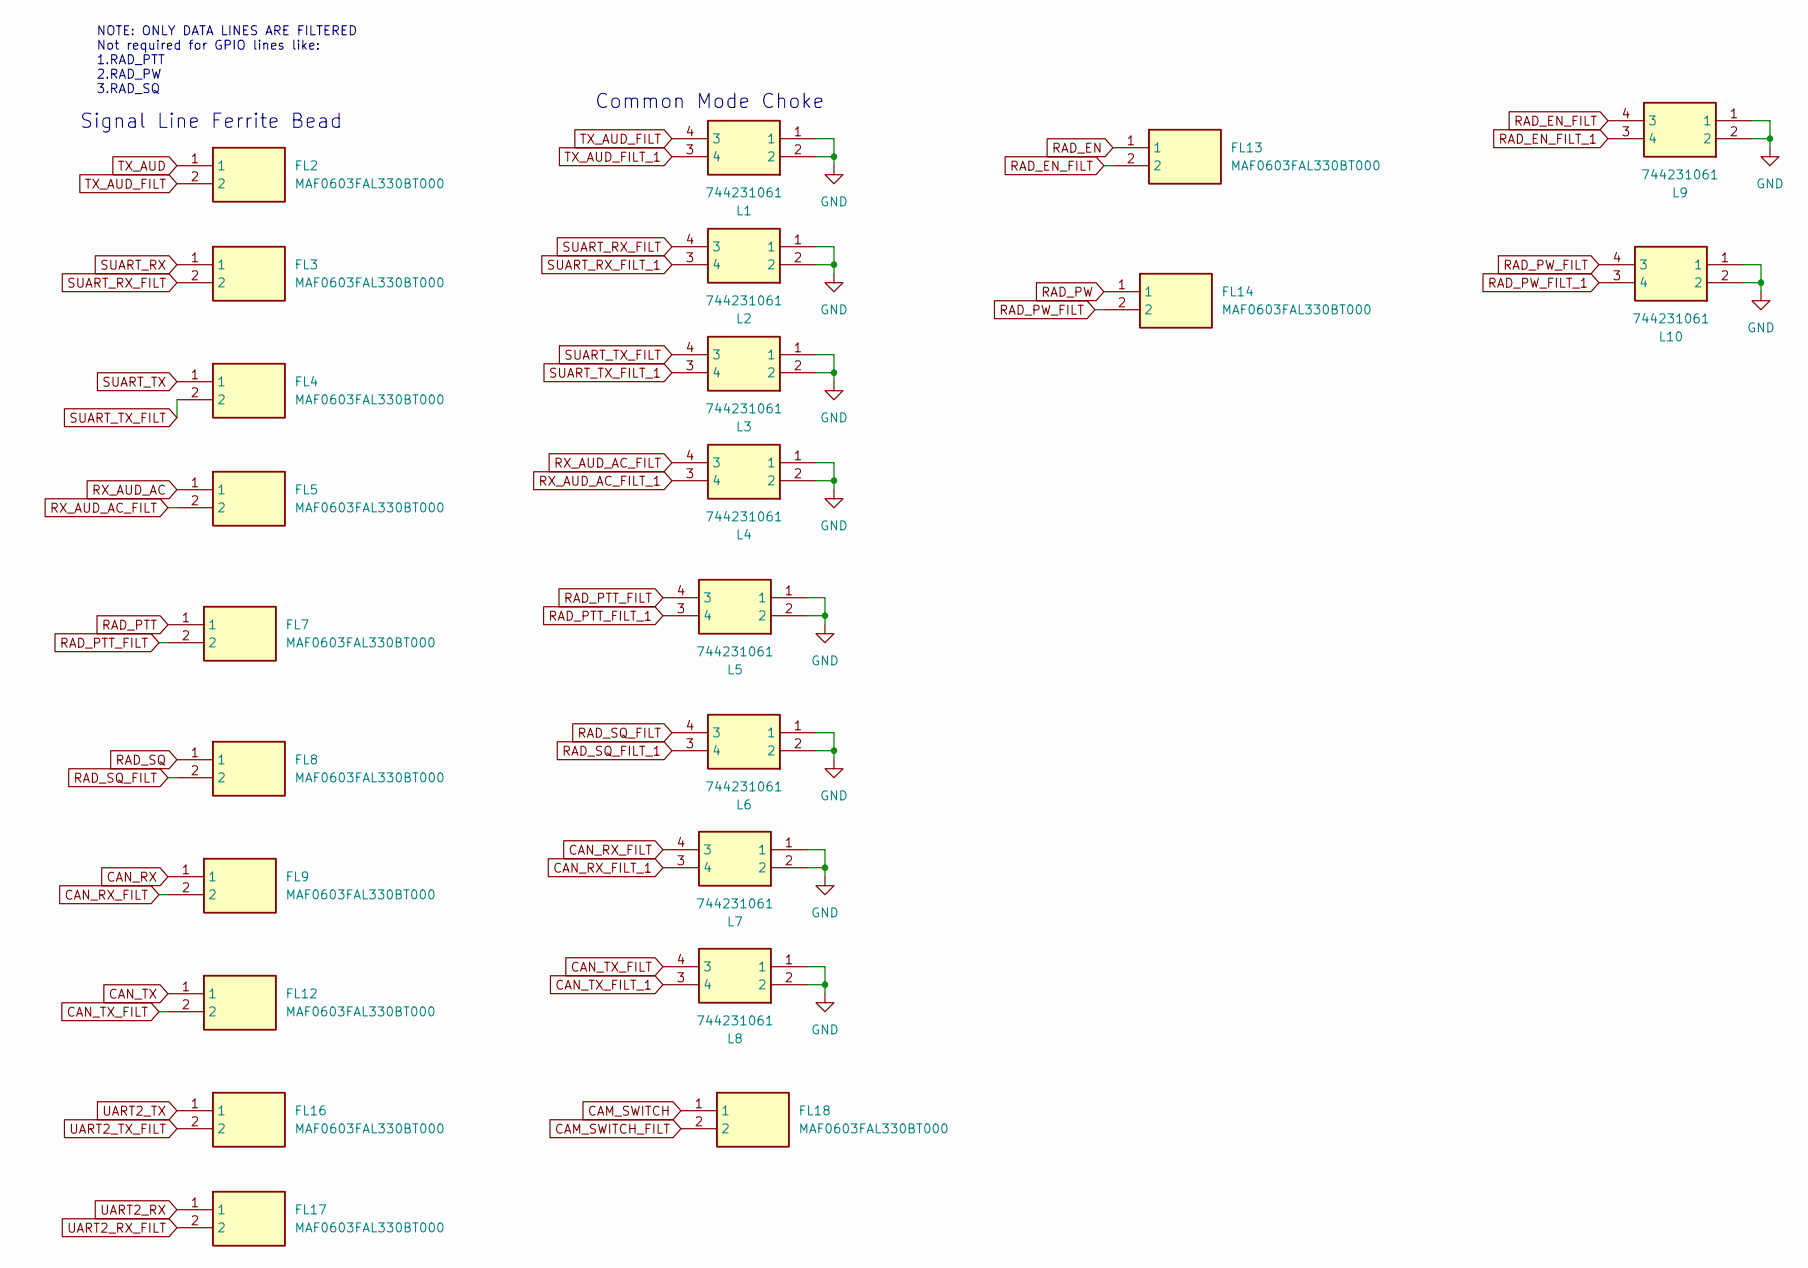
[picture p44: schematic COMMS_BOARD_EMIFIL.kicad_sch]

Parts:
FL2, FL3, FL4, FL5, FL7, FL8, FL9, FL12, FL13, FL14, FL16, FL17, FL18: MAF0603FAL330BT000; BEADC0603X33N; Mouser Part Number 810-MAF0603FAL330BT0
L1, L2, L3, L4, L5, L6, L7, L8, L9, L10: 744231061; WE-CNSW_08058; Mouser Part Number 710-744231061

Connections:
CAM_SWITCH: FL18.1; also elsewhere on the board
CAM_SWITCH_FILT: FL18.2; also elsewhere on the board
CAN_RX: FL9.1; also elsewhere on the board
CAN_RX_FILT: FL9.2, L7.4 (3)
CAN_RX_FILT_1: L7.3 (4); also elsewhere on the board
CAN_TX: FL12.1; also elsewhere on the board
CAN_TX_FILT: FL12.2, L8.4 (3)
CAN_TX_FILT_1: L8.3 (4); also elsewhere on the board
GND: L1.1, L1.2, L2.1, L2.2, L3.1, L3.2, L4.1, L4.2, L5.1, L5.2, L6.1, L6.2, L7.1, L7.2, L8.1, L8.2, L9.1, L9.2, L10.1, L10.2; also elsewhere on the board
RAD_EN: FL13.1; also elsewhere on the board
RAD_EN_FILT: FL13.2, L9.4 (3)
RAD_EN_FILT_1: L9.3 (4); also elsewhere on the board
RAD_PTT: FL7.1; also elsewhere on the board
RAD_PTT_FILT: FL7.2, L5.4 (3)
RAD_PTT_FILT_1: L5.3 (4); also elsewhere on the board
RAD_PW: FL14.1; also elsewhere on the board
RAD_PW_FILT: FL14.2, L10.4 (3)
RAD_PW_FILT_1: L10.3 (4); also elsewhere on the board
RAD_SQ: FL8.1; also elsewhere on the board
RAD_SQ_FILT: FL8.2, L6.4 (3)
RAD_SQ_FILT_1: L6.3 (4); also elsewhere on the board
RX_AUD_AC: FL5.1; also elsewhere on the board
RX_AUD_AC_FILT: FL5.2, L4.4 (3)
RX_AUD_AC_FILT_1: L4.3 (4); also elsewhere on the board
SUART_RX: FL3.1; also elsewhere on the board
SUART_RX_FILT: FL3.2, L2.4 (3)
SUART_RX_FILT_1: L2.3 (4); also elsewhere on the board
SUART_TX: FL4.1; also elsewhere on the board
SUART_TX_FILT: FL4.2, L3.4 (3)
SUART_TX_FILT_1: L3.3 (4); also elsewhere on the board
TX_AUD: FL2.1; also elsewhere on the board
TX_AUD_FILT: FL2.2, L1.4 (3)
TX_AUD_FILT_1: L1.3 (4); also elsewhere on the board
UART2_RX: FL17.1; also elsewhere on the board
UART2_RX_FILT: FL17.2; also elsewhere on the board
UART2_TX: FL16.1; also elsewhere on the board
UART2_TX_FILT: FL16.2; also elsewhere on the board

Notes on the sheet:
Signal Line Ferrite Bead
NOTE: ONLY DATA LINES ARE FILTERED Not required for GPIO lines like: 1.RAD_PTT 2.RAD_PW 3.RAD_SQ
Common Mode Choke

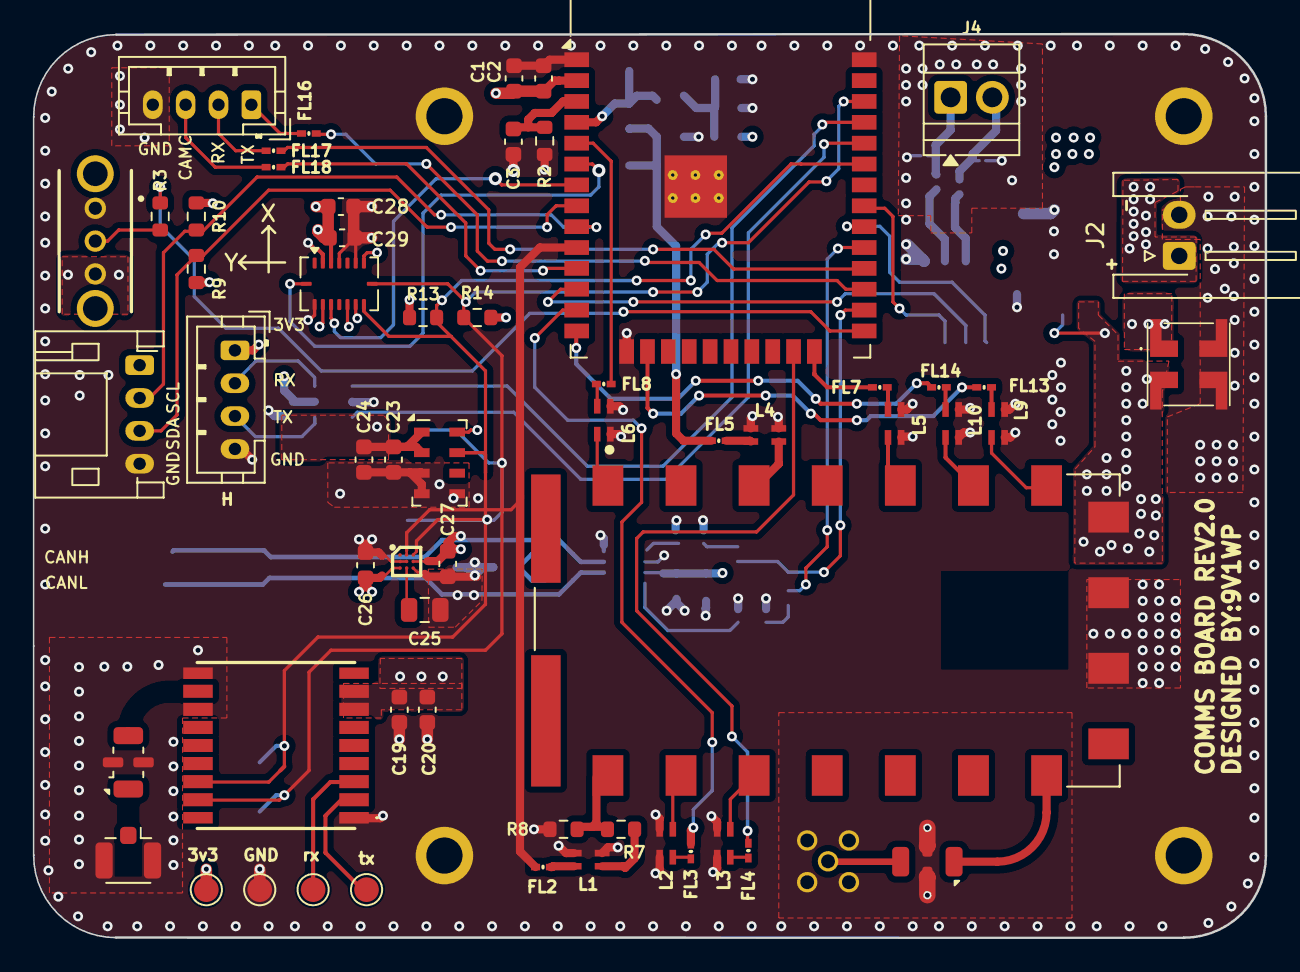
[picture p45: board COMMS_BOARD.kicad_pcb from above]

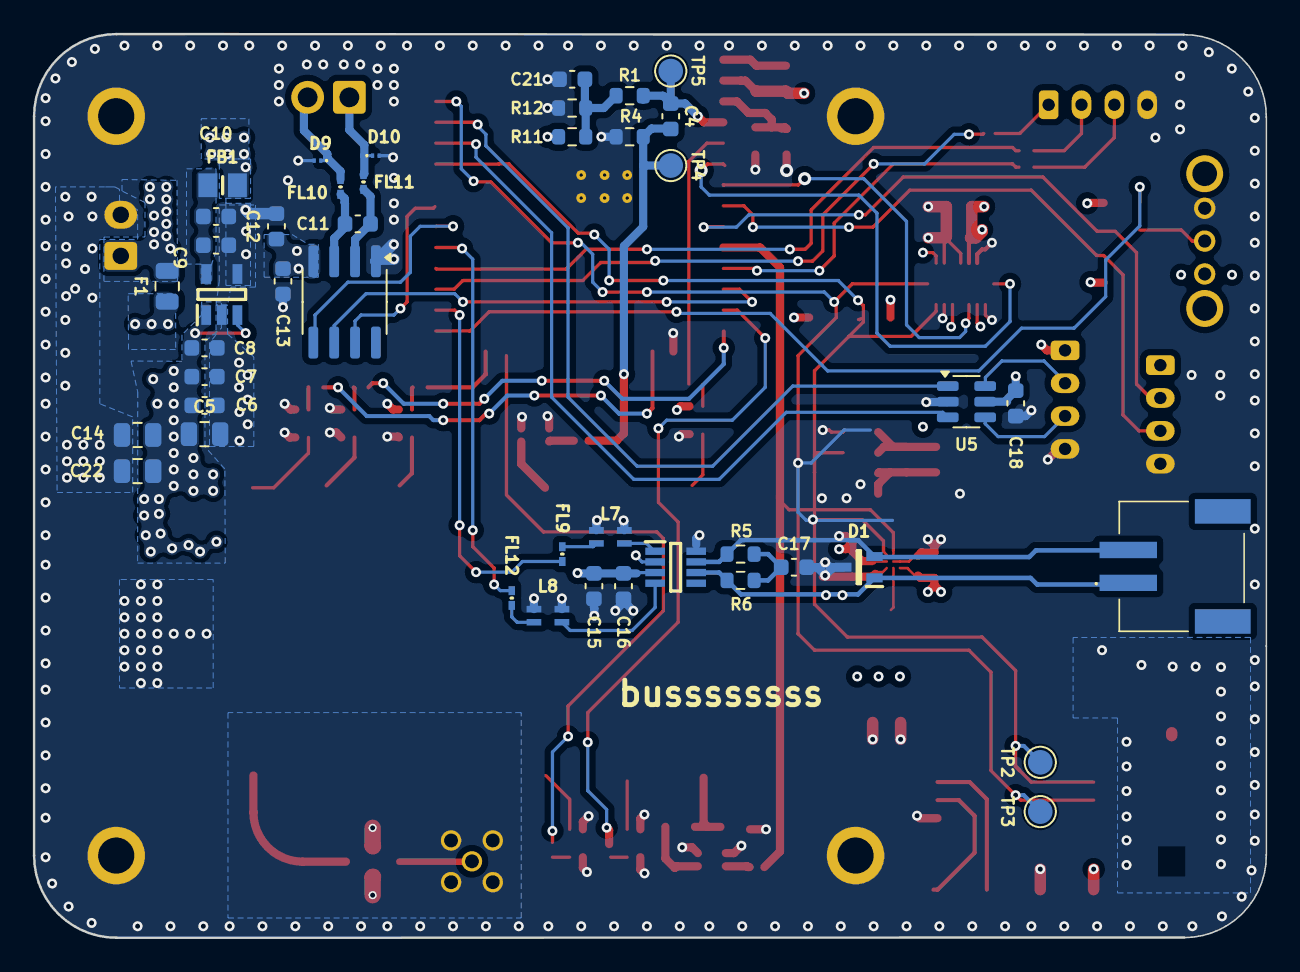
[picture p46: board COMMS_BOARD.kicad_pcb from below]

Board: 4 copper layers, 75.0 x 55.0 mm, 107 parts (43 on the bottom side), 73 nets.

Other parts of the board:
FL19: DLW5ATH111TQ2L; DLW5BSN302SQ2L
IC3: MAX-M10S-00B; MAXM10S00B

Their connections:
+3V3: IC3.7 (V_IO), IC3.8 (VCC); also elsewhere on the board
EN_LDO: FL19.2, FL19.6; also elsewhere on the board
GND: FL19.3, FL19.4, FL19.7, FL19.8, IC3.1 (GND_1), IC3.10 (GND_2), IC3.12 (GND_3); also elsewhere on the board
GNSS_UARTRX: IC3.3 (RXD); also elsewhere on the board
GNSS_UARTTX: IC3.2 (TXD); also elsewhere on the board
I2C_SDA: IC3.16 (SDA); also elsewhere on the board
I2C_SDL: IC3.17 (SCL); also elsewhere on the board
unnamed 30: IC3.11 (RF_IN); also elsewhere on the board
VDD: FL19.1, FL19.5; also elsewhere on the board
