RandomAerospace/COMMS-BOARD/(commit log)

2026-07-05 ADDE IMU
    [COMMS_BOARD.kicad_pcb, COMMS_BOARD.kicad_sch, COMMS_BOARD_CAN_BUS.kicad_sch, COMMS_BOARD_EMIFIL.kicad_sch, COMMS_BOARD_EXTERNAL_CONNS.kicad_sch, COMMS_BOARD_RADIO.kicad_sch, COMMS_BOARD_SENSORS.kicad_sch]
2026-07-05 REV2 RELEASE
    IO34 AND 35 are inputs, so these are interrupts from IMU
    [COMMS_BOARD.kicad_pcb, COMMS_BOARD_EXTERNAL_CONNS.kicad_sch]
2026-07-16 routing nearly done!
    To do: Probably an solder bridge to bridge across the VTX_EN and cutter_EXT pins, perhaps just delete it
